sLeon2005/Actuador-Nivel-de-Agua/diagrama_esquemático.png

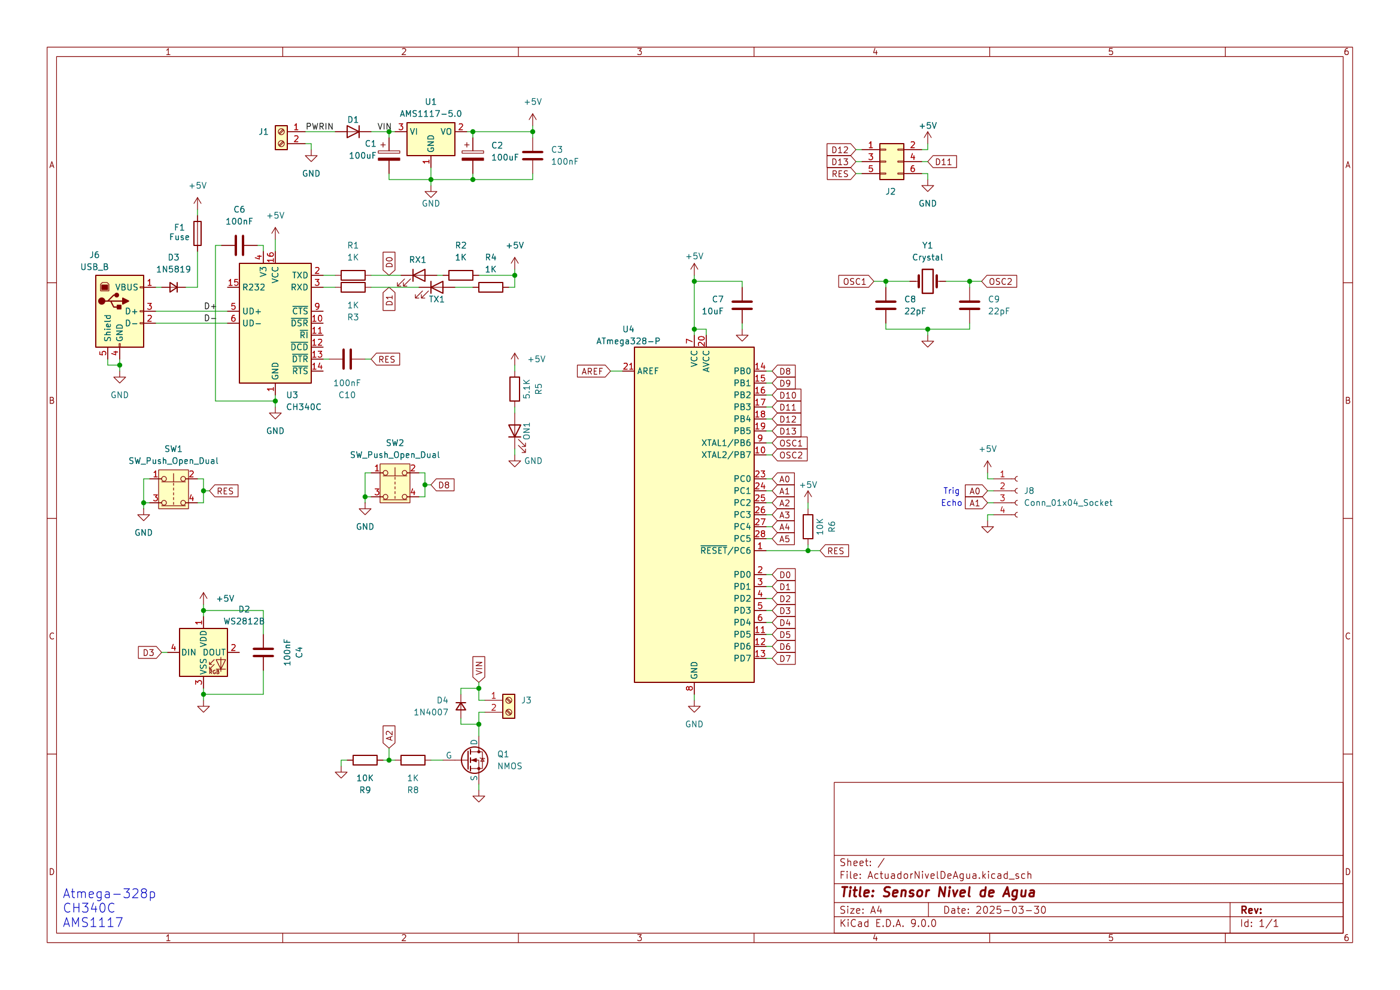
diagrama_esquemático.png
