sLeon2005/Actuador-Nivel-de-Agua/pcb_layout.png

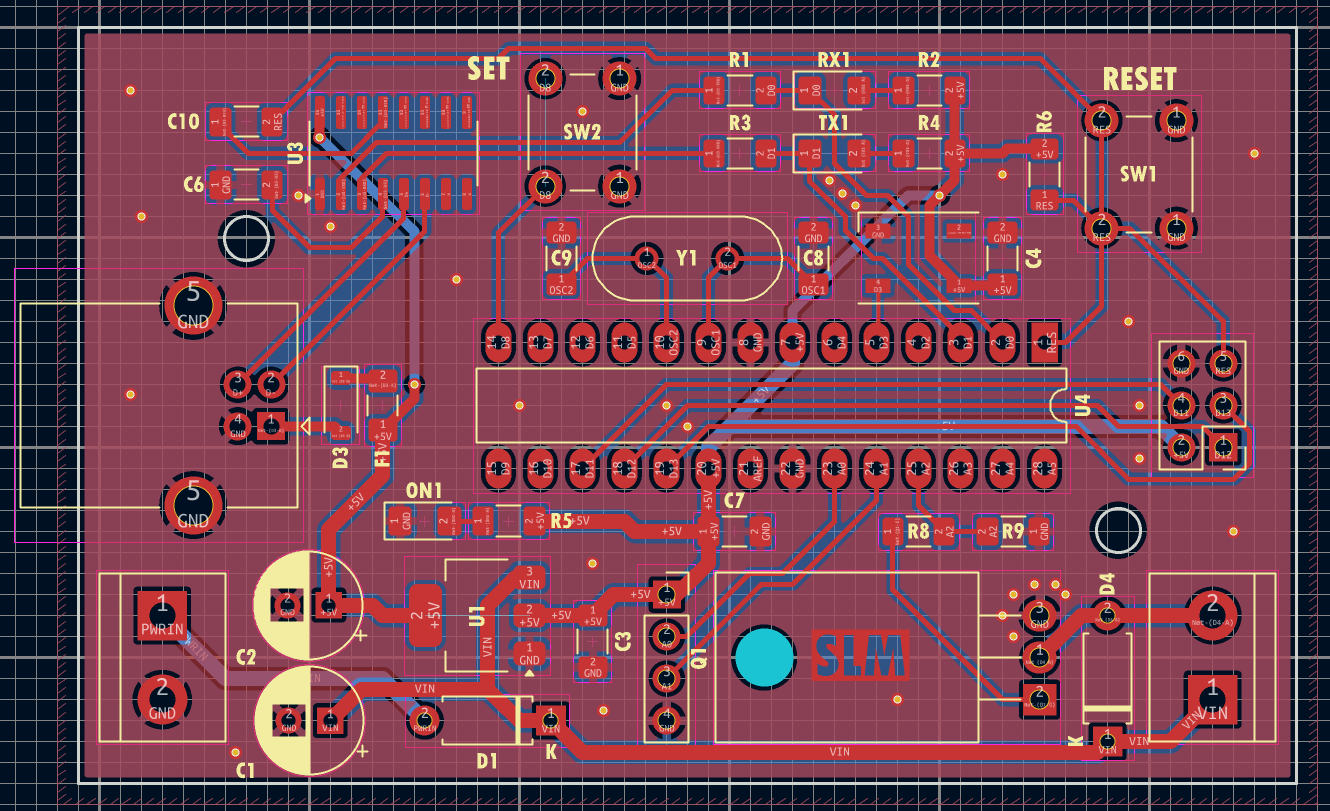
pcb_layout.png
