sLeon2005/Actuador-Nivel-de-Agua/(commit log)

2025-03-31 agregar fotos circuito
2025-03-31 gerbers de manufactura
2025-03-31 agregué el render 3d
2025-03-31 agregar bom
2025-03-31 desc de bom
